Smejky338/Heating_ESP_control_with_WiFi_MQTT/wiring/PCB detail.jpg

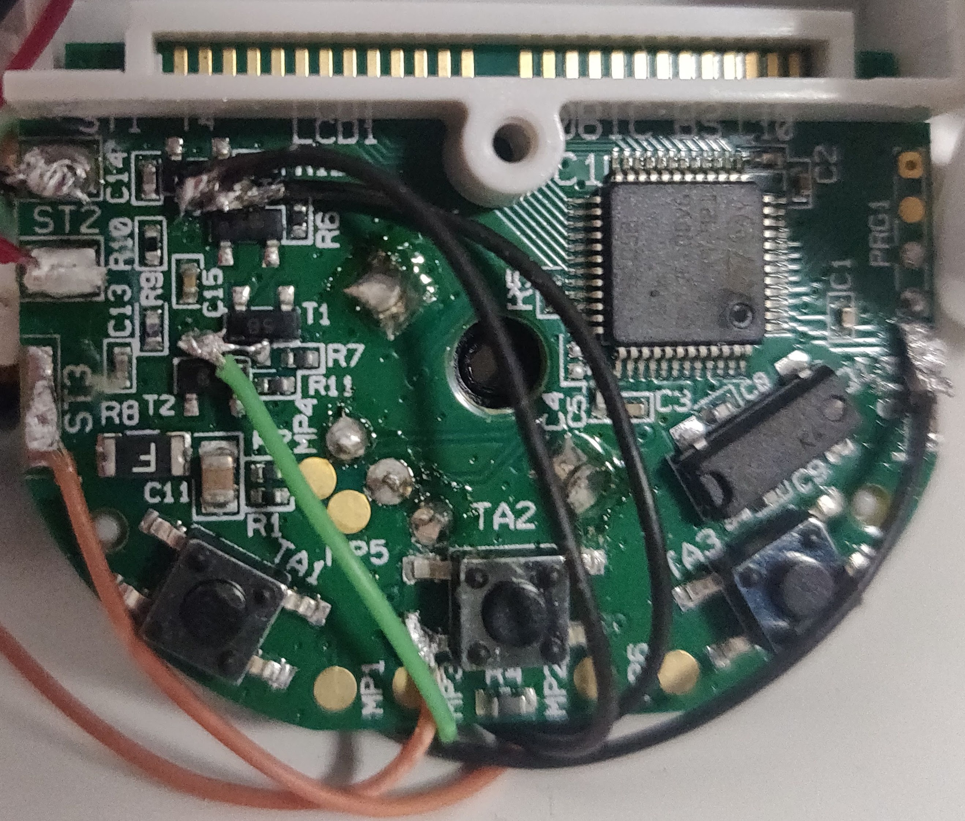
wiring/PCB detail.jpg
