Smejky338/Heating_ESP_control_with_WiFi_MQTT/wiring/overall.jpg

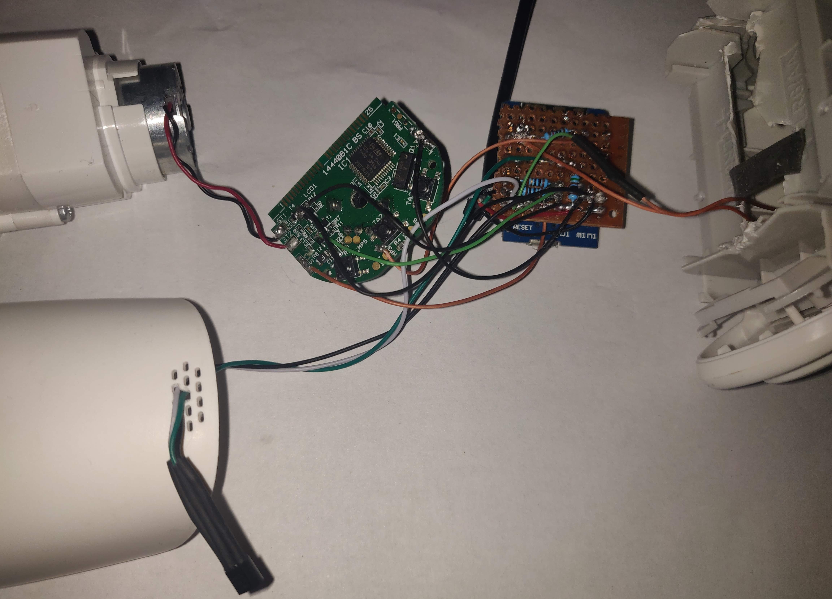
wiring/overall.jpg
