Smejky338/Heating_ESP_control_with_WiFi_MQTT/wiring/Wiring diagram for valve head.png

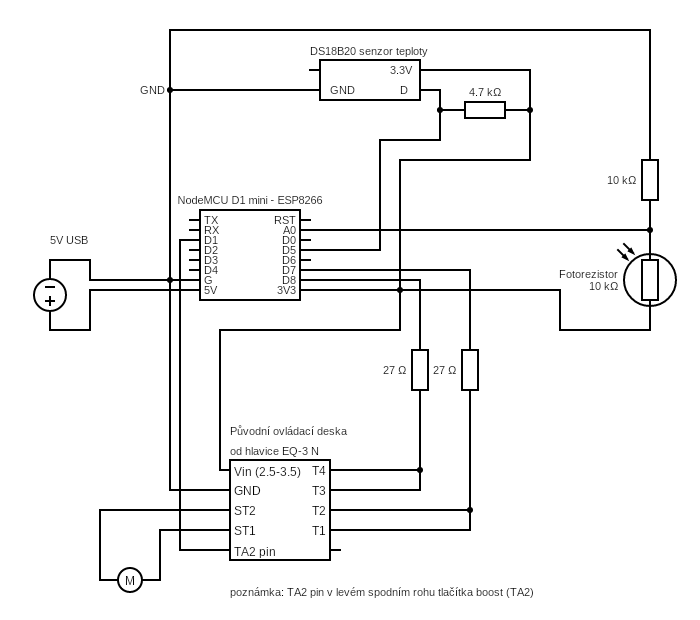
wiring/Wiring diagram for valve head.png
