Smejky338/Heating_ESP_control_with_WiFi_MQTT/(commit log)

2021-04-16 Added boost mode control, polished code
    boost from button or MQTT
2021-04-23 Moved over from dev, cleaned up code
    http server store to flashfile system and load on bootup
    multiplied PID inputs since it accepts whole numbers only
    added light sensor readings and publishing via MQTT
2021-04-26 Added introduction, changed PID variables, altered MQTT boost communication
2021-05-02 Updated comments, lowered PID tuning variables
2021-05-09 Added documentation, changed motor control to 70% PWM, cleaned up code
2021-05-11 Added real-life pictures to wiring section
